cmarius46/-to---drinking-assistant/media/README.md

# perpetuum_spring_2021

## Making of : ȘTO 

### Proiectare - Se masoara de doua ori si se taie o data !

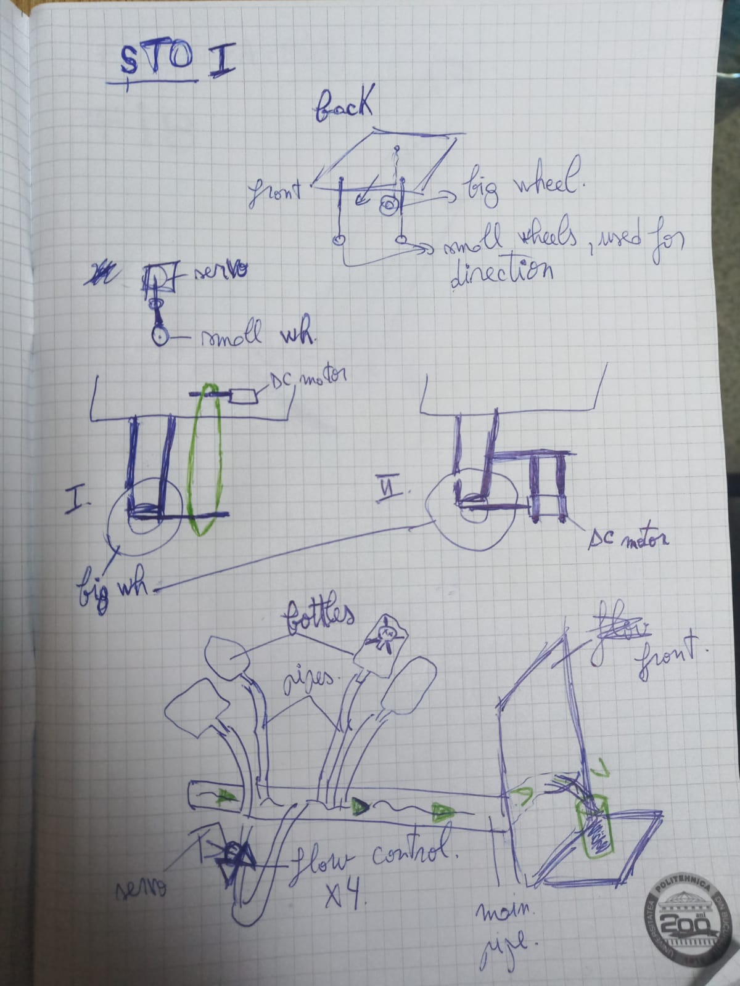
[picture p5: media/proiectare/0_ th1_main_hw.jpeg]
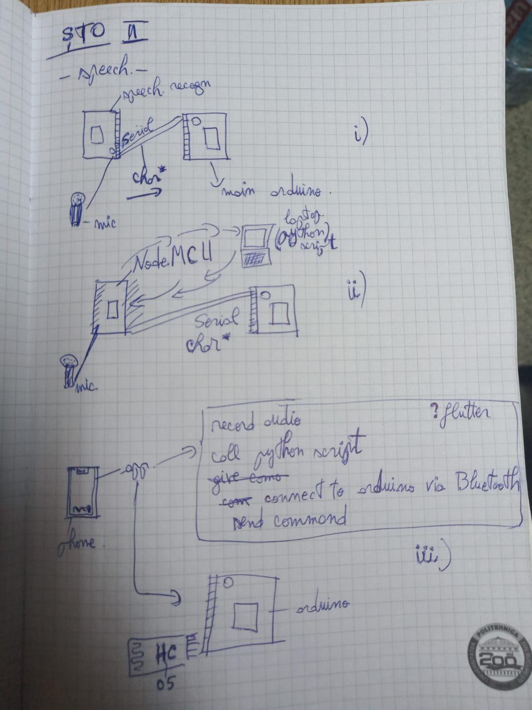
[picture p6: media/proiectare/0_ th2_speech.jpeg]
 

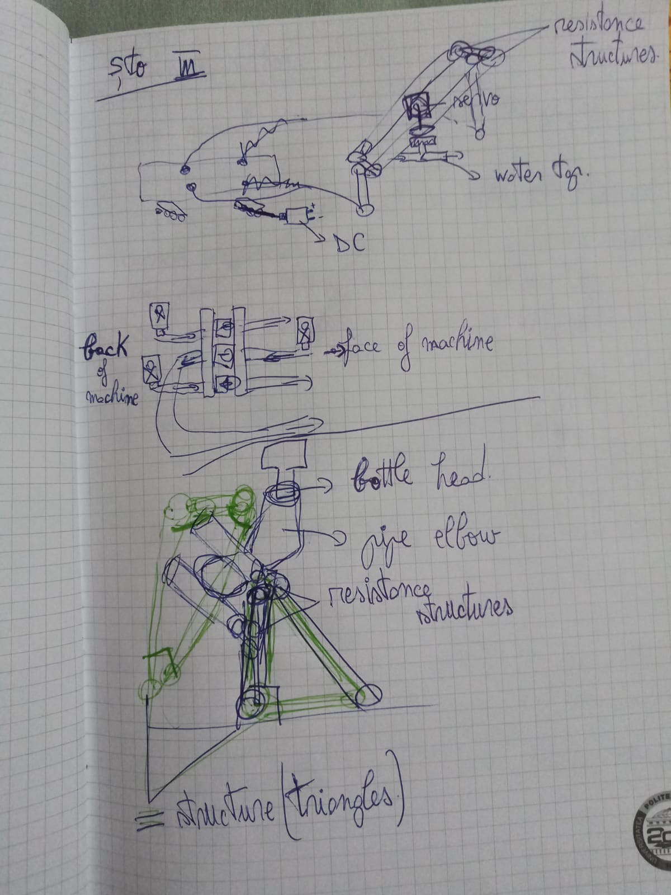
[picture p7: media/proiectare/0_ th3_main_structure.jpeg]
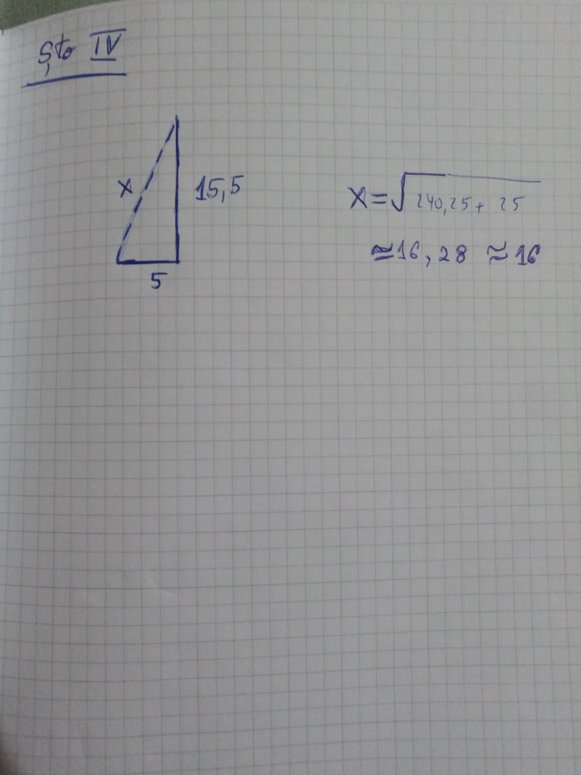
[picture p8: media/proiectare/0_ th4_pitagora.jpeg]
 

### Implementare - Teoria ca teoria, dar practica ne omoara :)

#### 0_brico; 1_materials; 2_size_matters : 

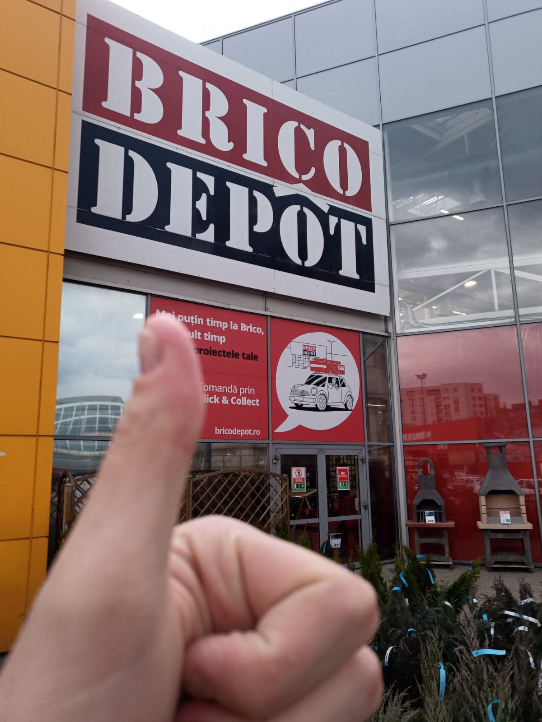
[picture p9: media/implementare/0_brico.jpeg]
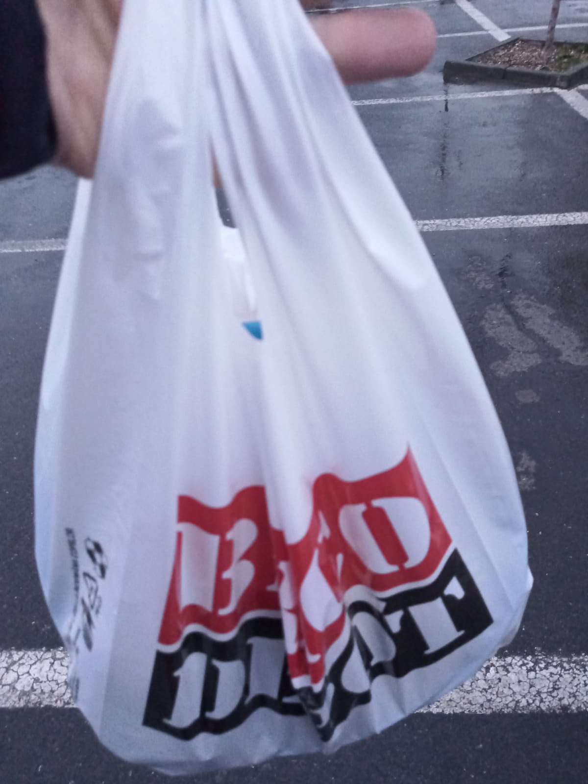
[picture p10: media/implementare/1_materials.jpeg]
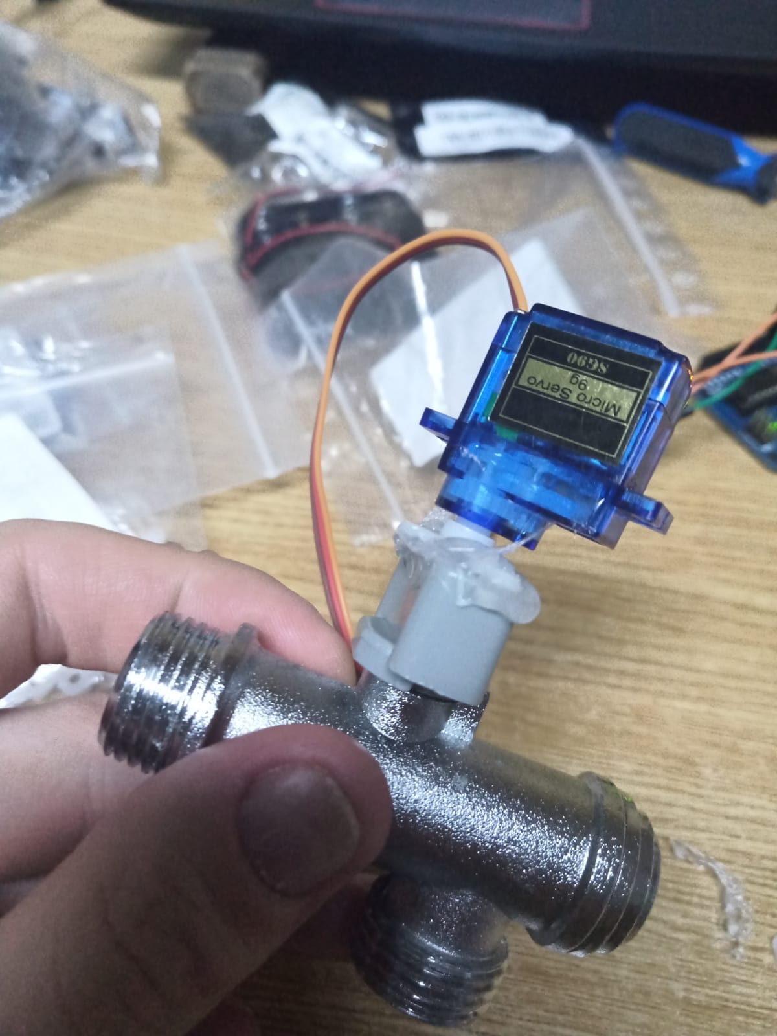
[picture p11: media/implementare/2_size_matters.jpeg]
  

#### 3_base_parts; 4_motor_bottom; 5_seamana : 

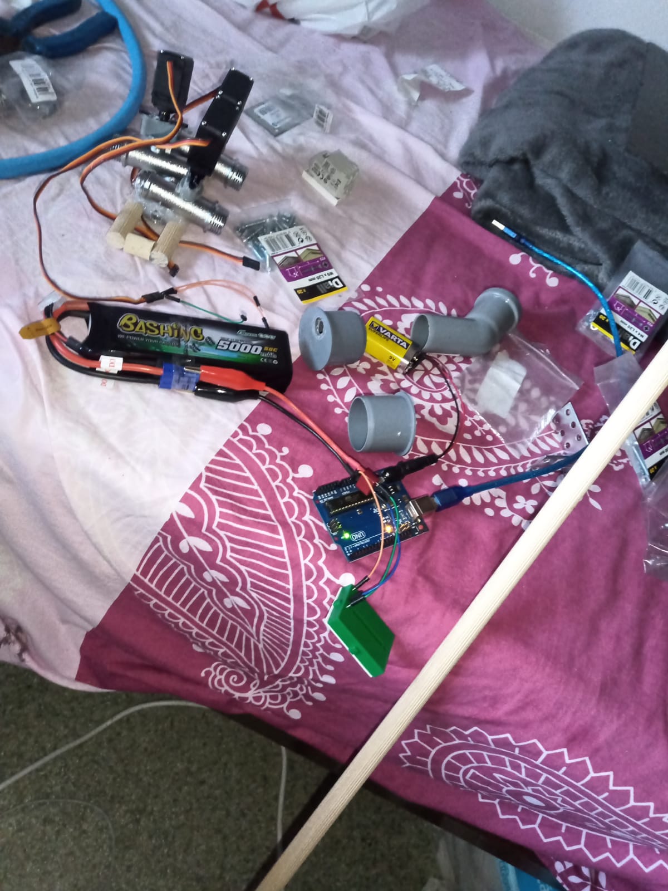
[picture p12: media/implementare/3_base_parts.jpeg]
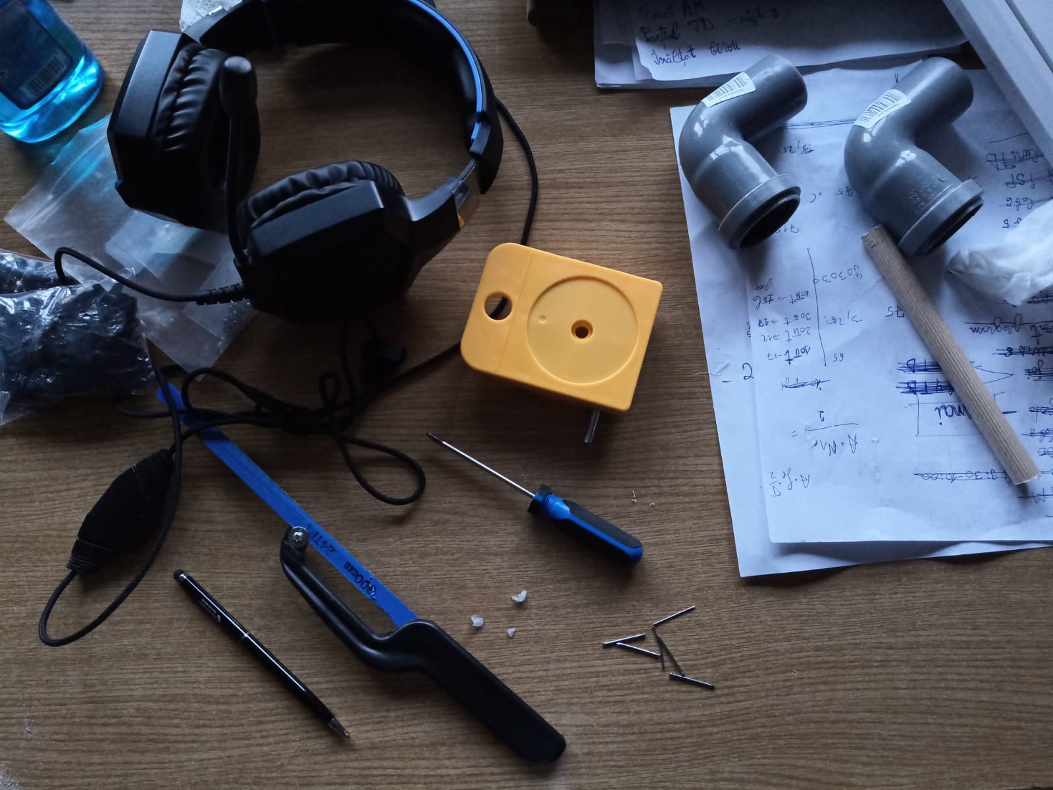
[picture p13: media/implementare/4_motor_bottom.jpeg]
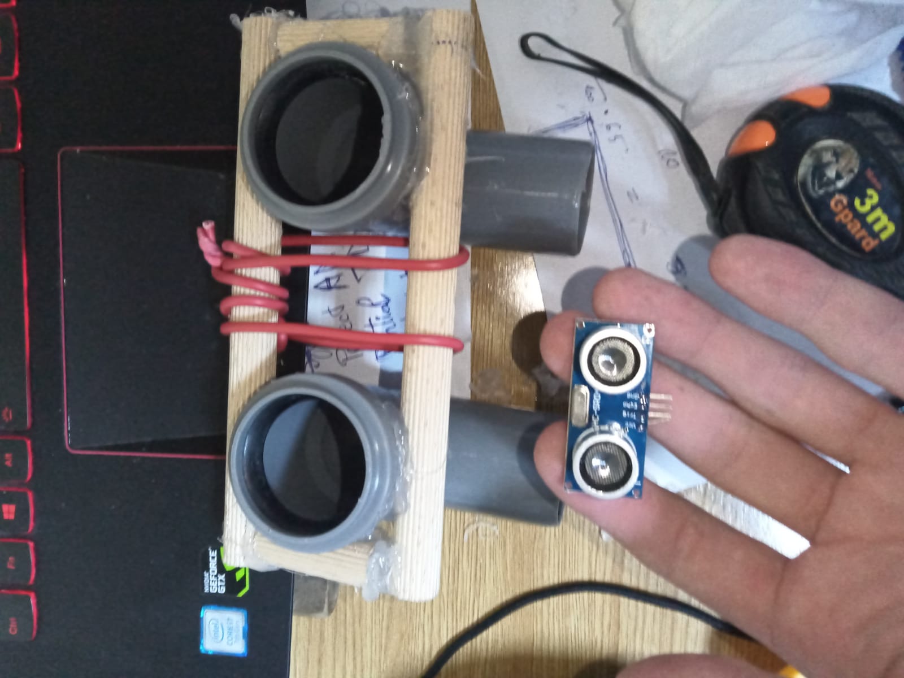
[picture p14: media/implementare/5_seamana.jpeg]
  

#### 6_robinete; 7_alimentare_1; 8_alimentare_2 : 

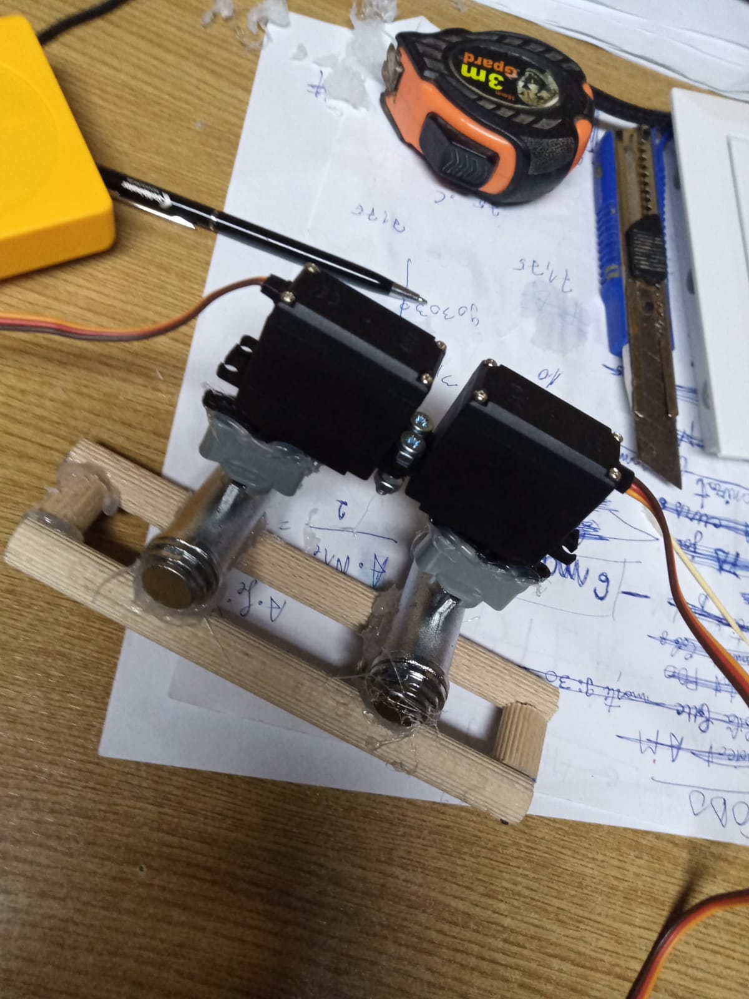
[picture p15: media/implementare/6_robinete.jpeg]
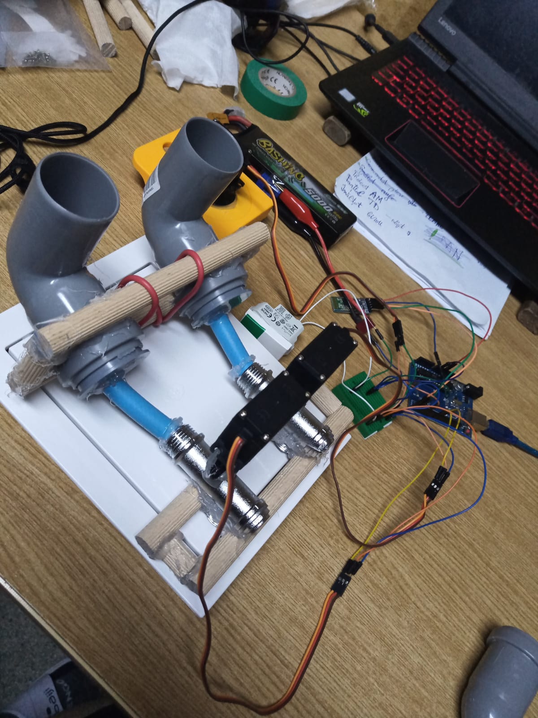
[picture p16: media/implementare/7_alimentare_1.jpeg]
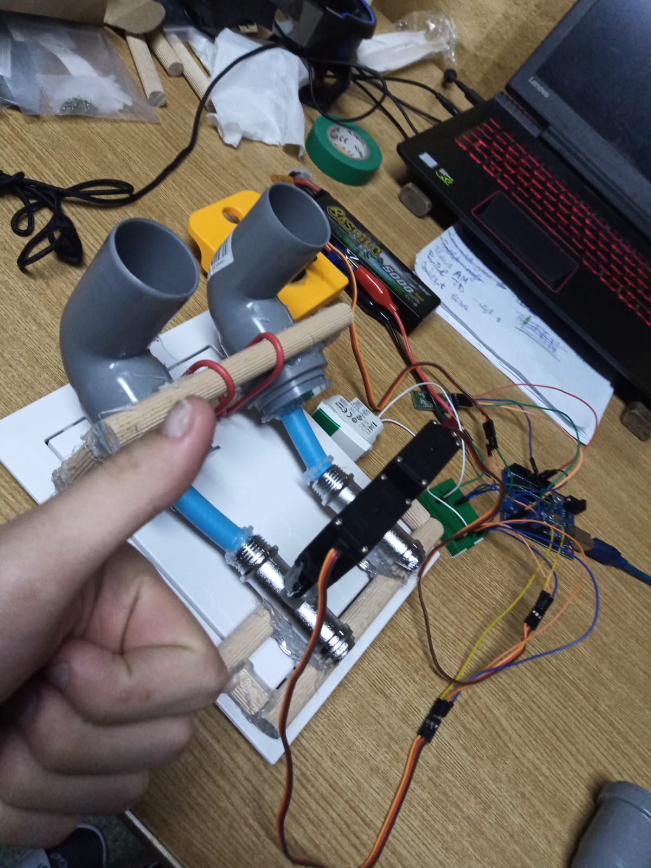
[picture p17: media/implementare/8_alimentare_2.jpeg]
  

#### 9_main_frame_b; 10_main_frame; 11_rezistenta : 

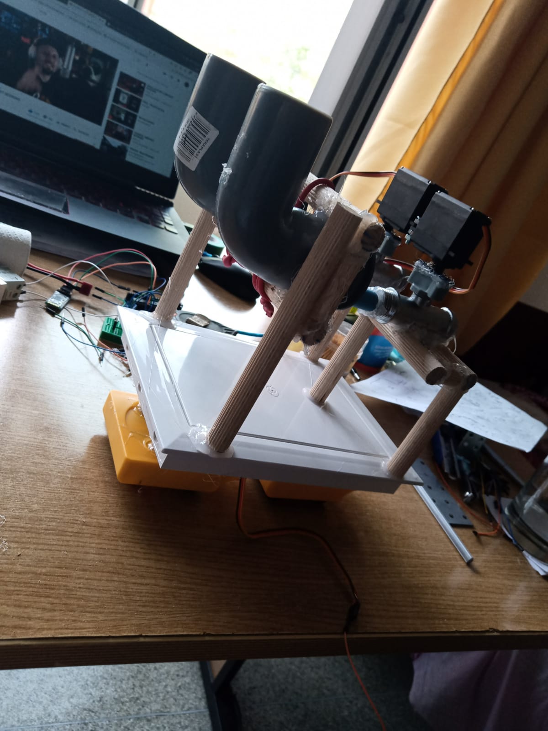
[picture p18: media/implementare/10_mainframe.jpeg]
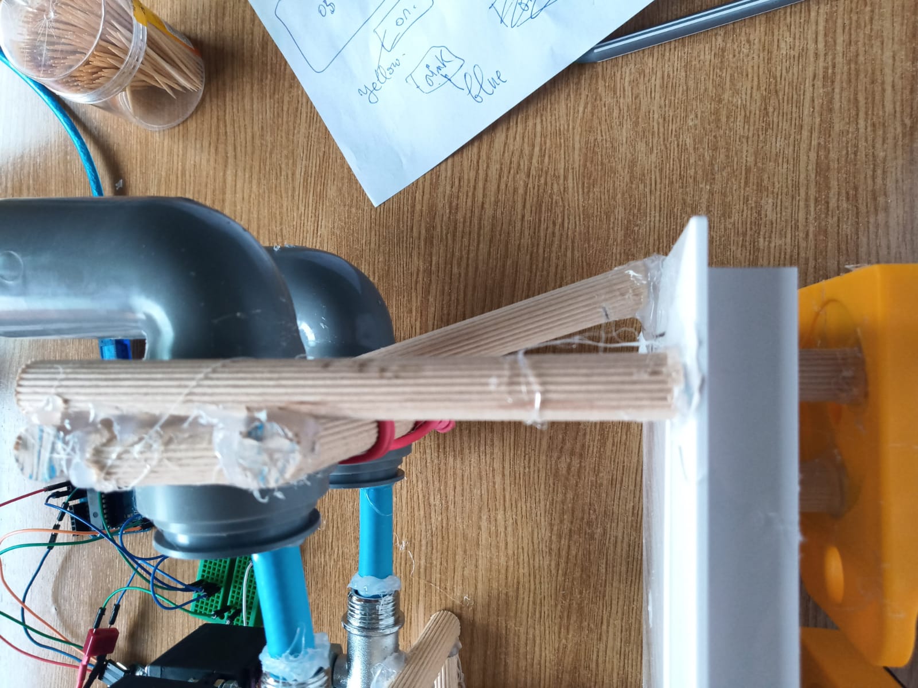
[picture p19: media/implementare/11_rezistenta.jpeg]
  

#### 12_SDcard; 13_laterale; 14_front1 : 

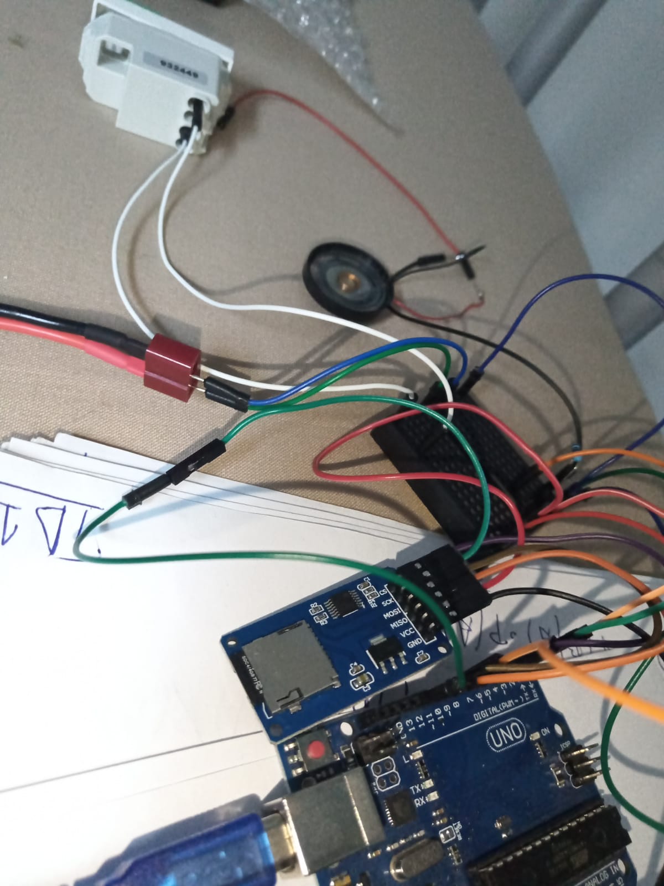
[picture p20: media/implementare/12_SDcard.jpeg]
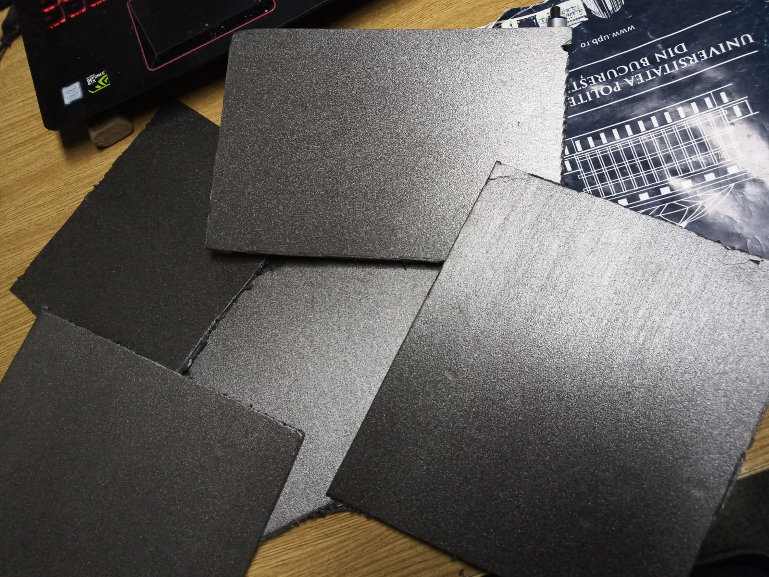
[picture p21: media/implementare/13_laterale.jpeg]
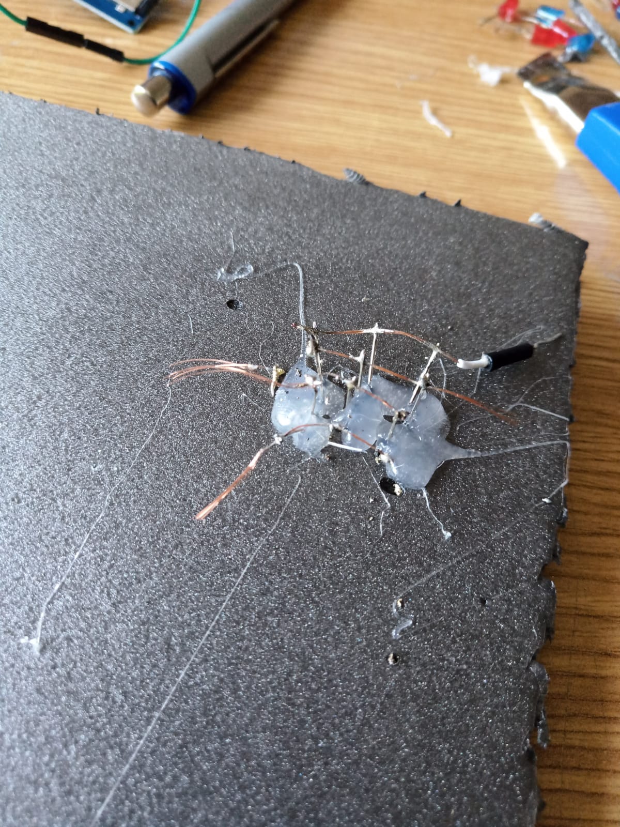
[picture p22: media/implementare/14_front1.jpeg]
  

#### 15_front2; 16_assembly1; 17_assembly2 : 

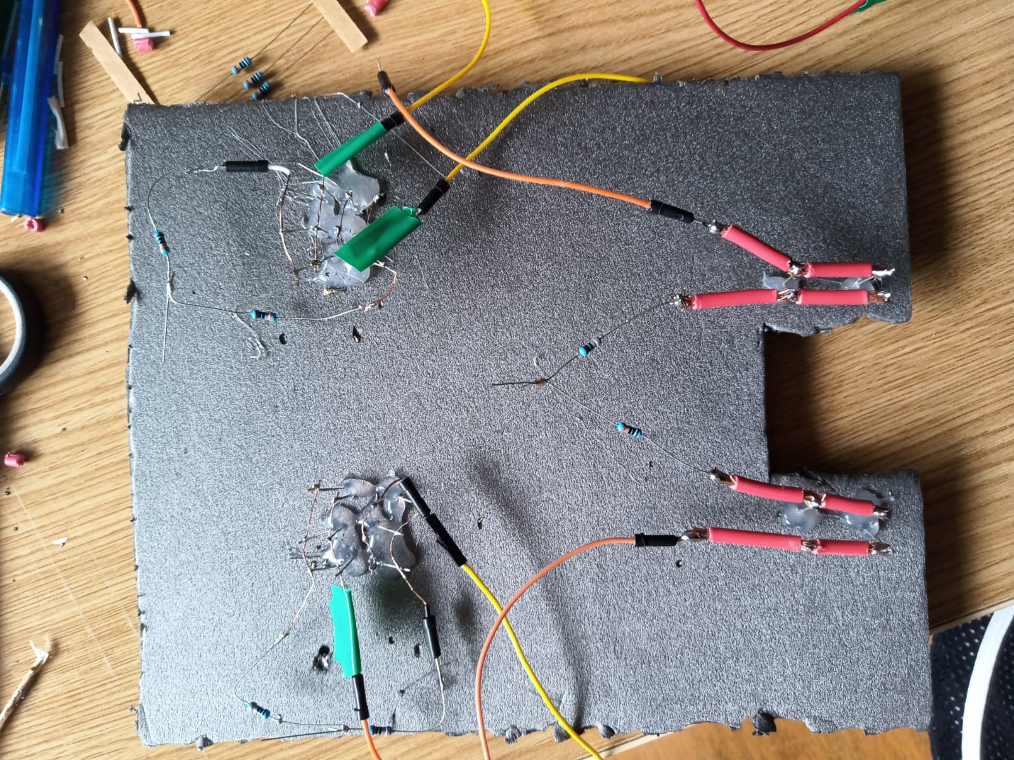
[picture p23: media/implementare/15_front2.jpeg]
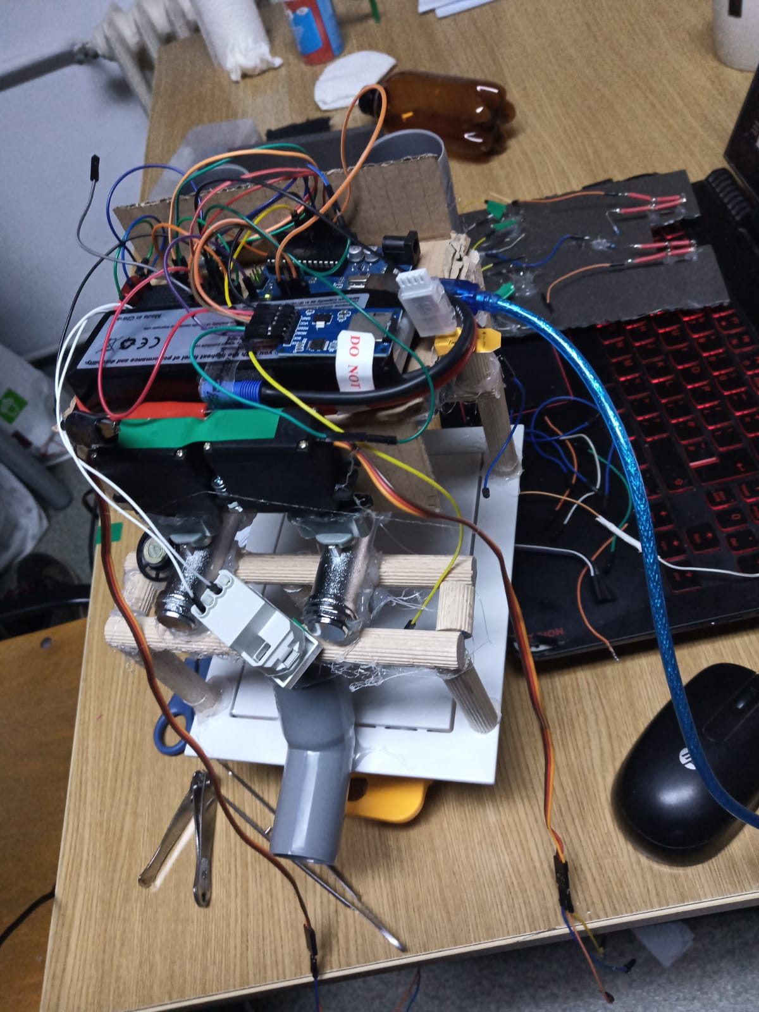
[picture p24: media/implementare/16_assembly1.jpeg]
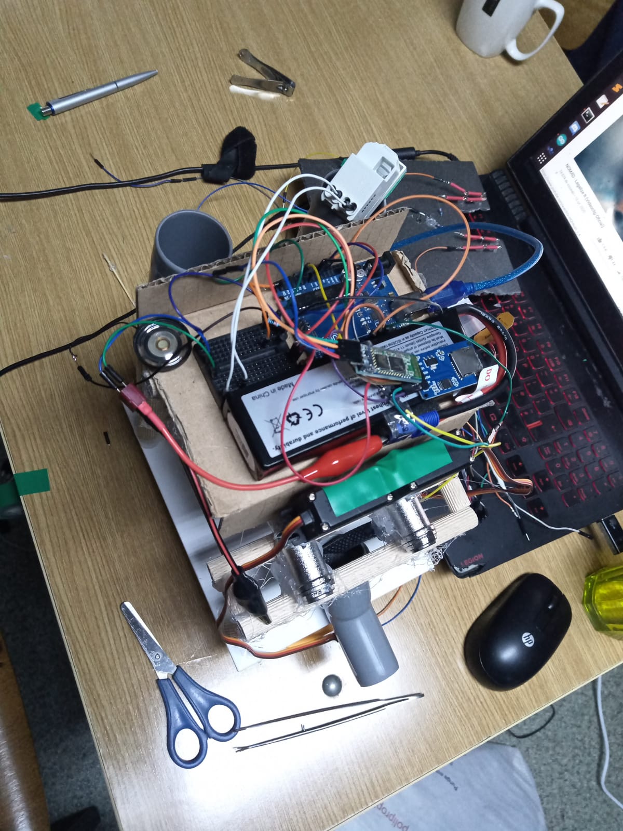
[picture p25: media/implementare/17_assembly2.jpeg]
  

#### 18_assembled1; 19_assembled2; 20_assembled3 : 

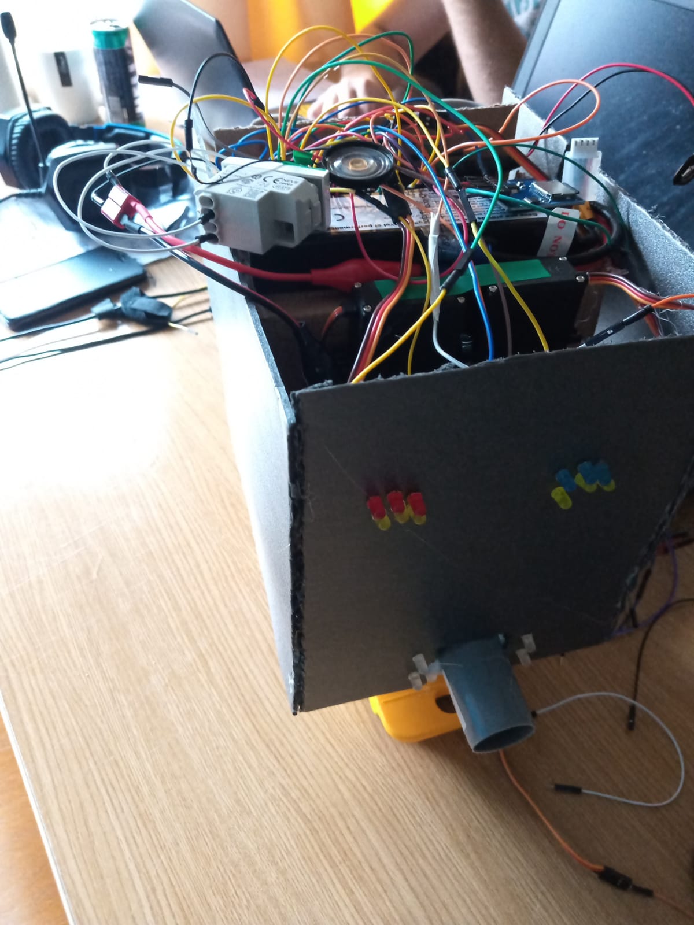
[picture p26: media/implementare/18_assembled1.jpeg]
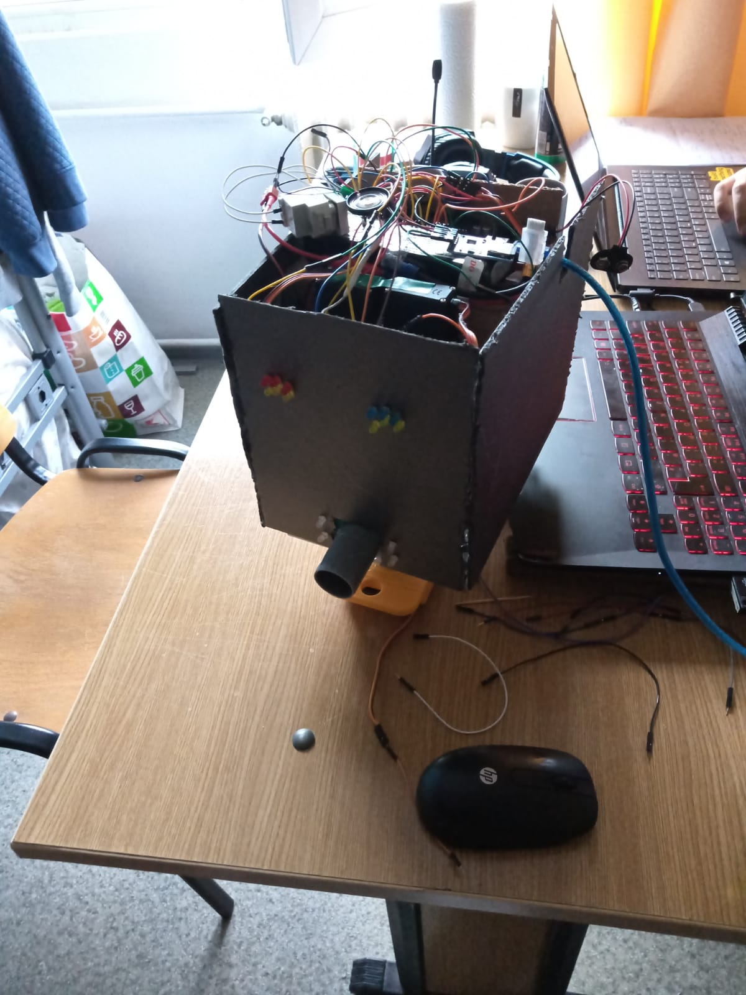
[picture p27: media/implementare/19_assembled2.jpeg]
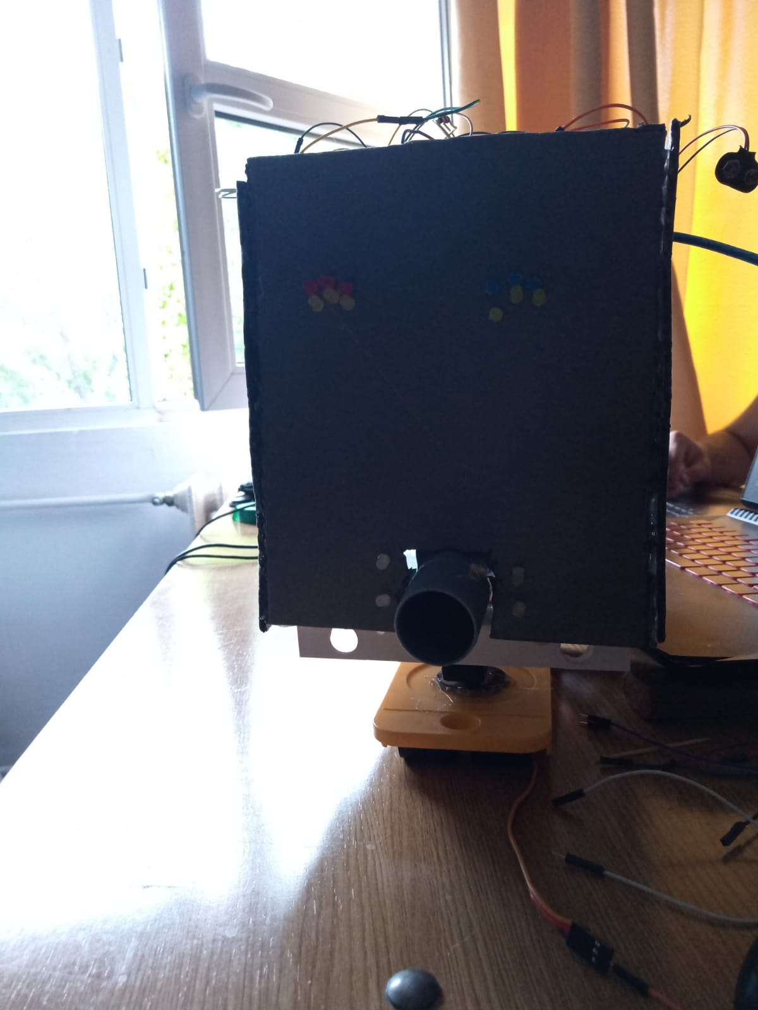
[picture p28: media/implementare/20_assembled3.jpeg]
   

#### 21_insuficient; 22_scurt_la_12V; 23_friendly : 

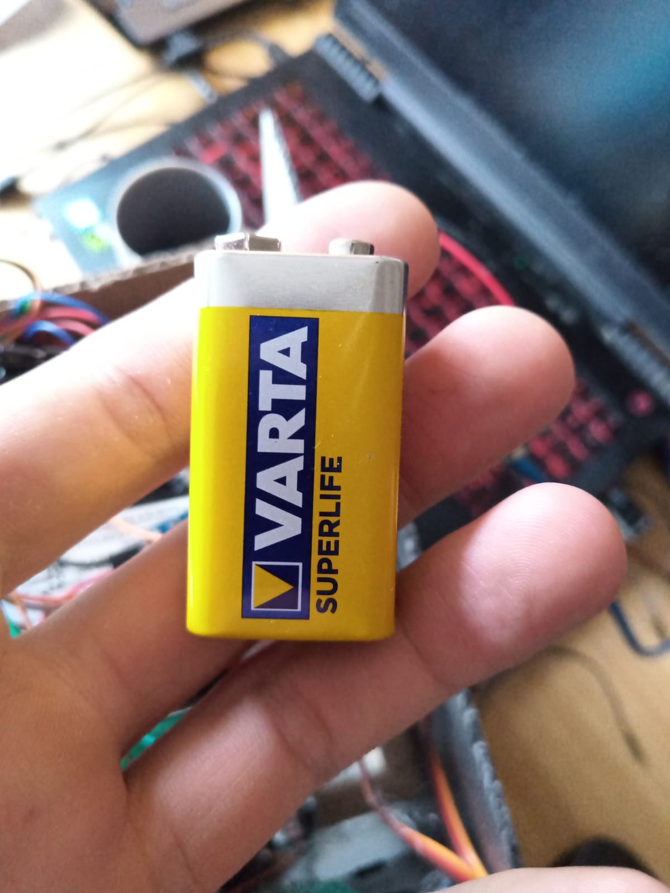
[picture p29: media/implementare/21_insuficient.jpeg]
  

#### 24_idle; 25_safety_first; 28_final : 

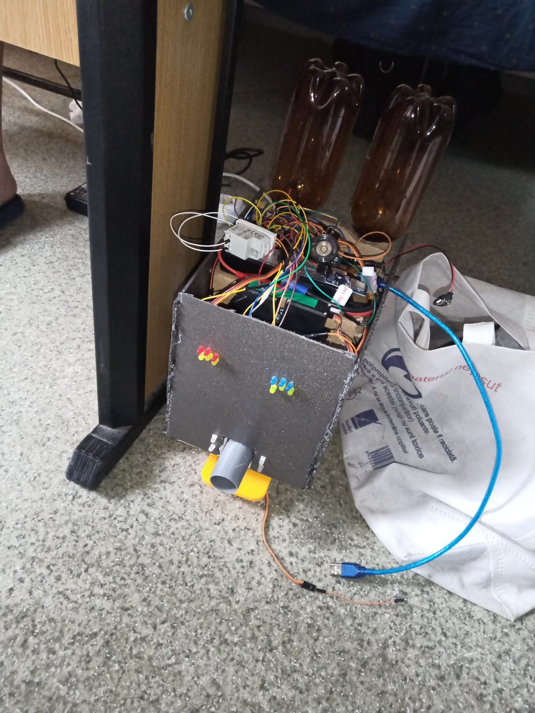
[picture p30: media/implementare/24_idle.jpeg]
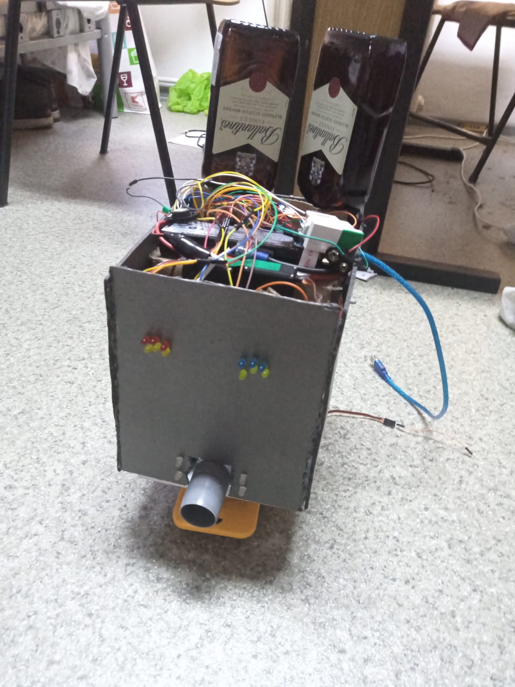
[picture p31: media/implementare/28_final.jpeg]
