cmarius46/-to---drinking-assistant/media/proiectare/README.md

# perpetuum_spring_2021
Se masoara de doua ori si se taie o data !
