cmarius46/-to---drinking-assistant/media/diagrama Gantt/Diagrama Gantt Perpetuum 2021.pdf

Săptămana | 1 | 2 | 3 | 4 | 5
18 apr. | 25 apr. | 26 apr. | 2 Mai | 3 Mai | 9 Mai | 10 Mai | 16 Mai | 17 mai | 22 mai
Proiectare si organizare | Design initial workflow
| Design initial hardware
| Procurare componente de baza
| | Testarea presupunerilor initiale
| | Ajustarea designului hardware in functie de concluzii
Realizarea scheletului de baza | | Realizarea structurii de rezistenta
| | Montarea componentelor hardware mari pe schelet
| | | Testarea pipe-urilor pentru
| | | curgerea lichidului Rezolvarea problemelor de picurare
| | | Procurarea componentelor necesare pentru realizarea workflow-ului propus
Realizarea modulelor hardware + software | | | Realizarea modulara a montajelor (hardware + software) | Rezolvarea bug-urilor din cod
| | | | Impreunarea montajelor modulare intr-un singur circuit Rezolvarea interferentelor dintre diferitele tipuri de module folosite
| | | | Integrarea circuitului in cadrul scheletului existent | Realizarea interfetei cu led-uri

### Finalizare si testare

Realizarea marginilor
| Testarea robotului fara lichid Rezolvarea bug-urilor si a problemelor de alimentare
| Asigurarea decuplarii usoare a alimentarii in caz de urgenta
| Testarea robotului cu lichid
Documentare si prezentare | Update 1 | Realizarea filmuletului de prezentare Realizarea unei scurte documentatii Update 0 Update 2
