cmarius46/-to---drinking-assistant/media/diagrama Gantt/perioada de desfasurare.png

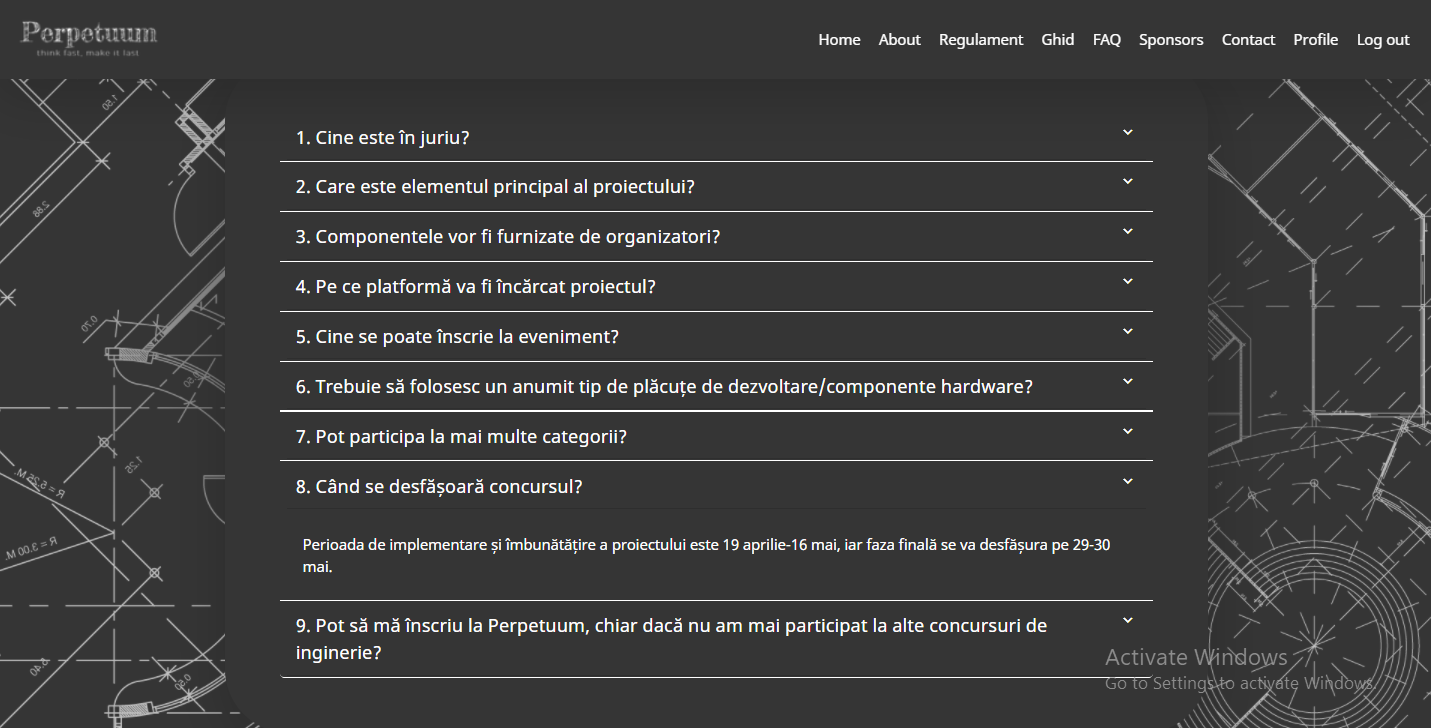
media/diagrama Gantt/perioada de desfasurare.png
