cmarius46/-to---drinking-assistant/sto_ino/sto_leds/sto_leds/sto_leds.ino

const int ledPin = A1;

void setup() {
  // put your setup code here, to run once:
  pinMode(ledPin, OUTPUT);
}

void loop() {

  digitalWrite(ledPin, HIGH);
  delay(150);
  digitalWrite(ledPin, LOW);
  delay(200);
  digitalWrite(ledPin, HIGH);
  delay(150);
  digitalWrite(ledPin, LOW);
  delay(200);
  digitalWrite(ledPin, HIGH);
  delay(100);
  digitalWrite(ledPin, LOW);
  delay(100);
  digitalWrite(ledPin, HIGH);
  delay(100);
  digitalWrite(ledPin, LOW);

  delay(5000);
  
  // put your main code here, to run repeatedly:

}
